briandorey/ESP8266-Mains-Energy-Monitor/Case/mains monitor case.dxf

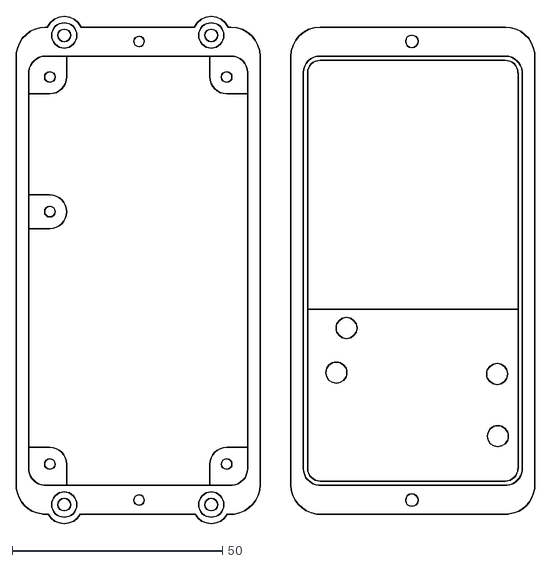
[picture p1: CAD file, 2016-01-01]
Case/mains monitor case.dxf
123.3 x 120.5
