briandorey/ESP8266-Mains-Energy-Monitor/(list of files, cad)

Other CAD files:
Firmware/PIC Gas Sensor/Gas Sensor.X/dist/default/production/Gas_Sensor.X.production.obj
