briandorey/ESP8266-Mains-Energy-Monitor/PCB-Files/Mains Monitor Schematic.pdf

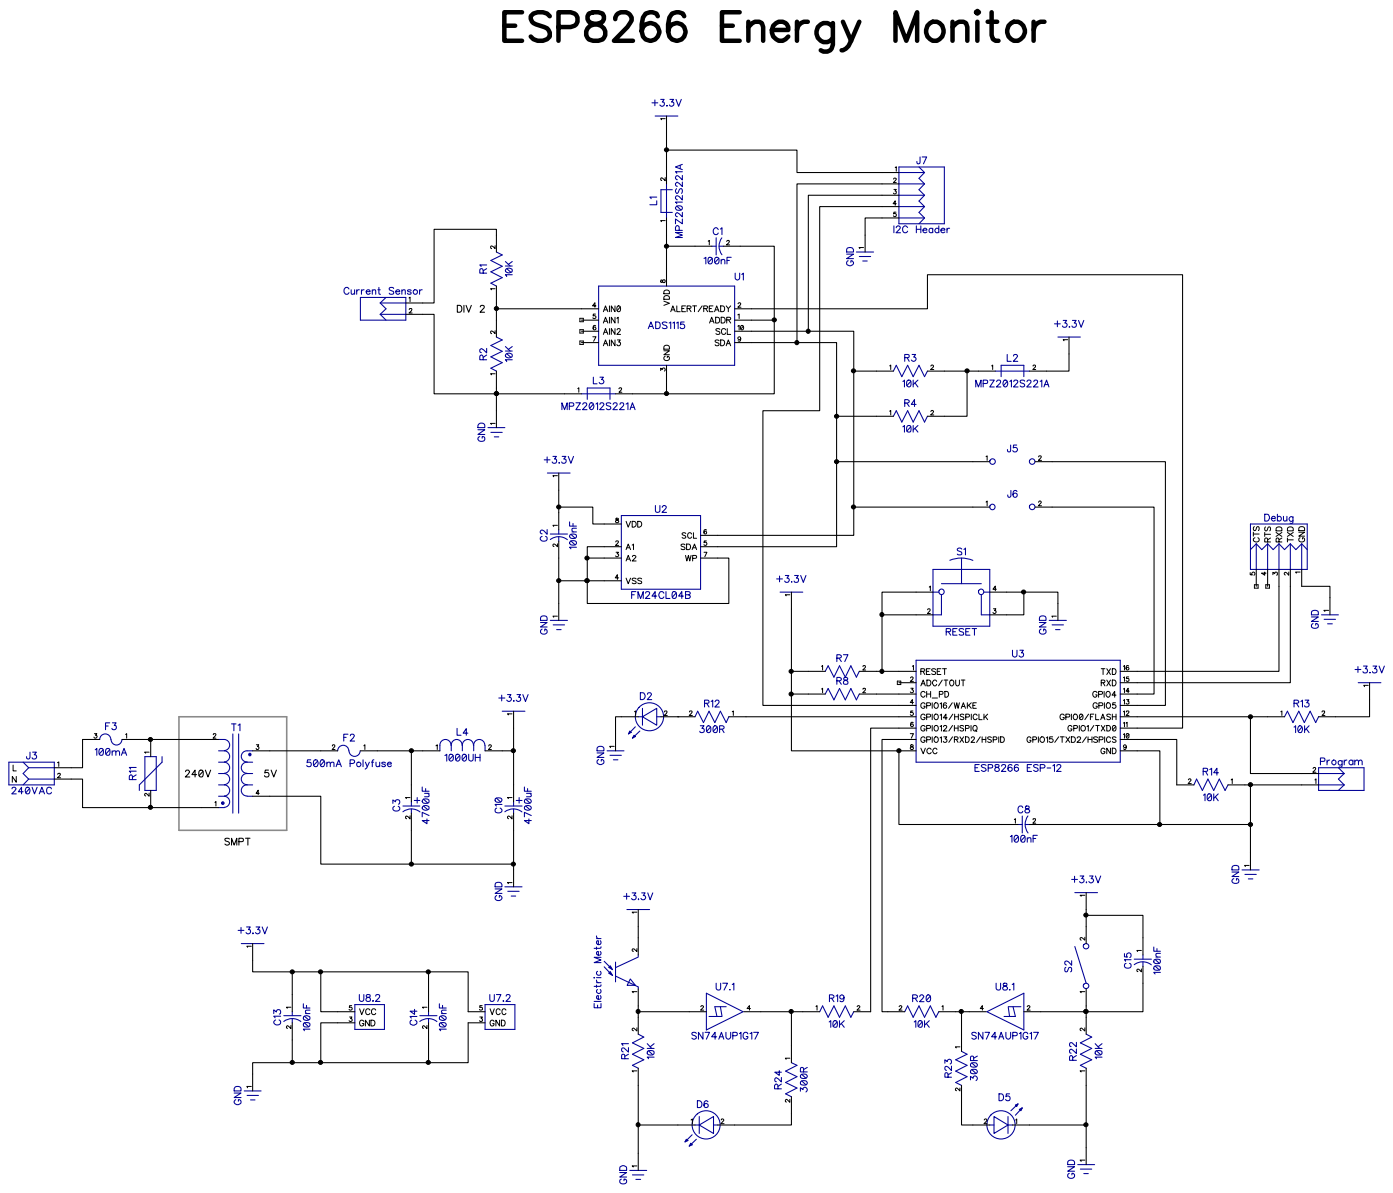
[picture p2: page 1]
