briandorey/ESP8266-Mains-Energy-Monitor/(list of files, drawings)

Other design files:
PCB-Files/Mains Monitor 1.1.dch
PCB-Files/Mains Monitor 1.1.dip
