briandorey/ESP8266-Mains-Energy-Monitor/(commit log)

2016-01-01 Upload of initial files
    [Mains Monitor 1.1.dch, Mains Monitor 1.1.dip, mains monitor case.dxf]
2016-01-12 Added gas sensor board firmware
    [Gas_Sensor.X.production.obj]
2023-05-08 Create MainsMonitorPulseOnly.ino
    PulseOnly Calculates Instantaneous watt consumption measuring the time elapsed between meter pulses, no need for a CT Current Sensor, the code was created based on Brian Dorey code and other project found online years ago, could not track the author to give proper credit.
